varununayak/follow_me_quad/Documentation/ACODS_presentation.pptx

## Target Tracking by a Quadrotor using Proximity Sensor Fusion

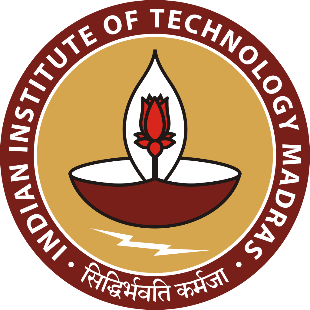
[picture p2: figure]

Varun Nayak[1], Raksha Rao Karaya[2]

[1]: Department of Mechanical Engineering, Birla Institute of Technology and Science, Pilani – K K Birla Goa Campus
[2]: Department of Aerospace Engineering, Indian Institute of Technology Madras

## Background

- Summer research work at the Department of Aerospace Engineering at IIT Madras in the Flight Dynamics and Control Group
- Lab focused on Multirotor Dynamics and Control.
- To develop a low-cost and computationally efficient system on a quadrotor to be able to detect and “follow” a moving object.
- Contribute to the lab’s objective of improving autonomy and efficiency of multirotor systems.

## Literature Review

- Camera and Machine Vision
  - Computational Cost – Ground Station Processing
  - Fails in visually-degraded environments
- Time of Flight Sensors
  - LiDaR – Payload Limitations; Open-ended environments
- Similar work using a combination of light-weight T-o-F sensors
Gageik et al (2015): Combines US and IR sensor but does not demonstrate object tracking

## Objective

- To detect and follow a solid object in front of a quadrotor by regulating its distance from it.
  - Develop this system on top of a low-level attitude controller of the quadrotor.
  - Make best use of available proximity sensors to generate the desired control signal – Filtering and Sensor Fusion
  - Implementation and experimental verification.
- Advantages: Computationally cheap, low-cost, readily available components, independent of light conditions, small payload

## Sensors

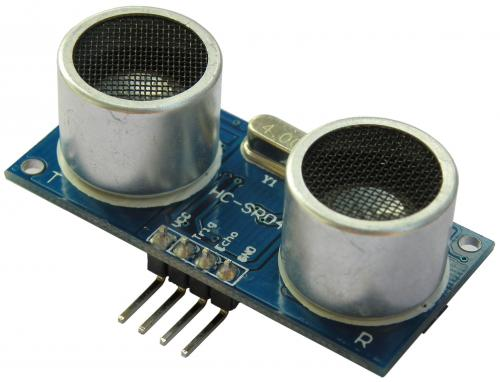
[picture p3: figure]
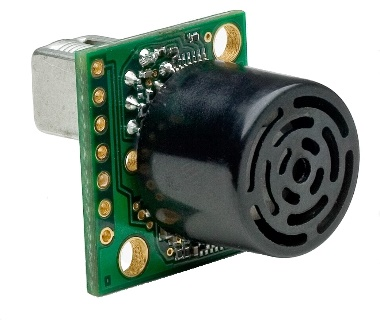
[picture p4: figure]

- Proximity sensors that operate using ultrasonic signals.
- Selection criteria – range, response for nature of surface, noise characteristics, measuring angle.
- Validated from visualizing raw-data.

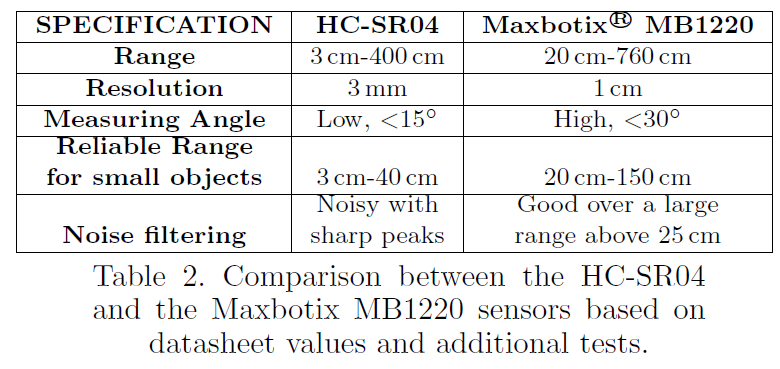
[picture p5: figure]

## Fully-assembled system

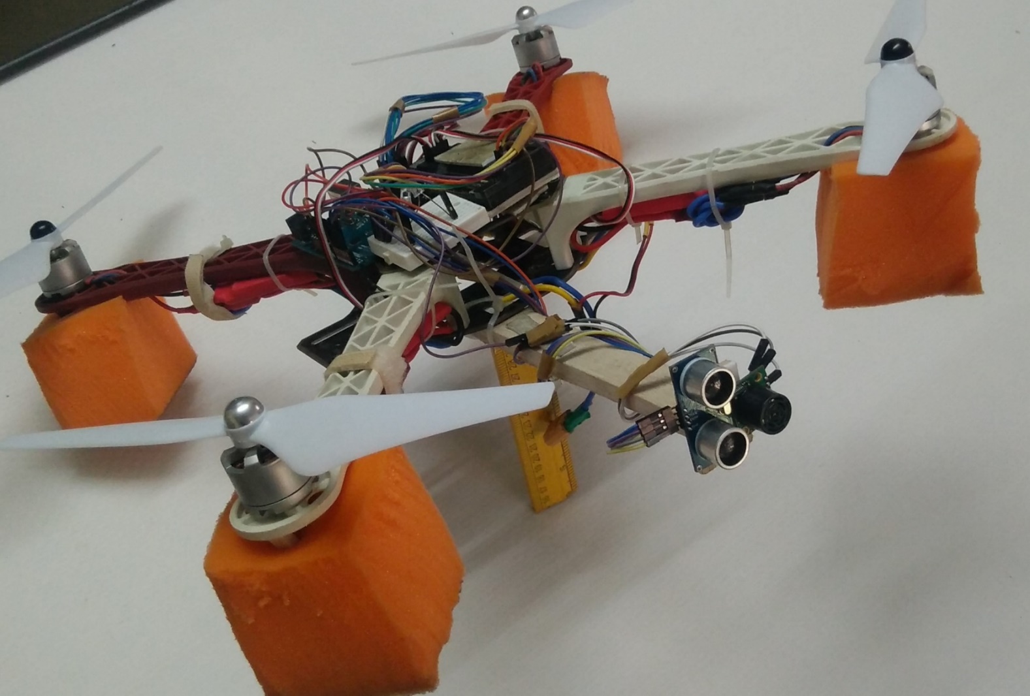
[picture p6: figure]

Flight Controller
+
Companion Board

Proximity Sensors

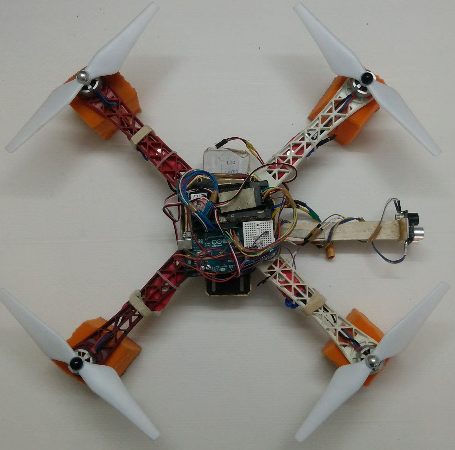
[picture p7: figure]

## Estimation: Filtering

- Important to ensure a smooth and reliable stream of proximity data as the output of the filter will drive the high-level controller of the quadrotors.
- Exponential Smoothening.
- Digital Filter.
- Noise Based (Gaussian) Filter.

## Estimation: Noise-based (Gaussian) filter

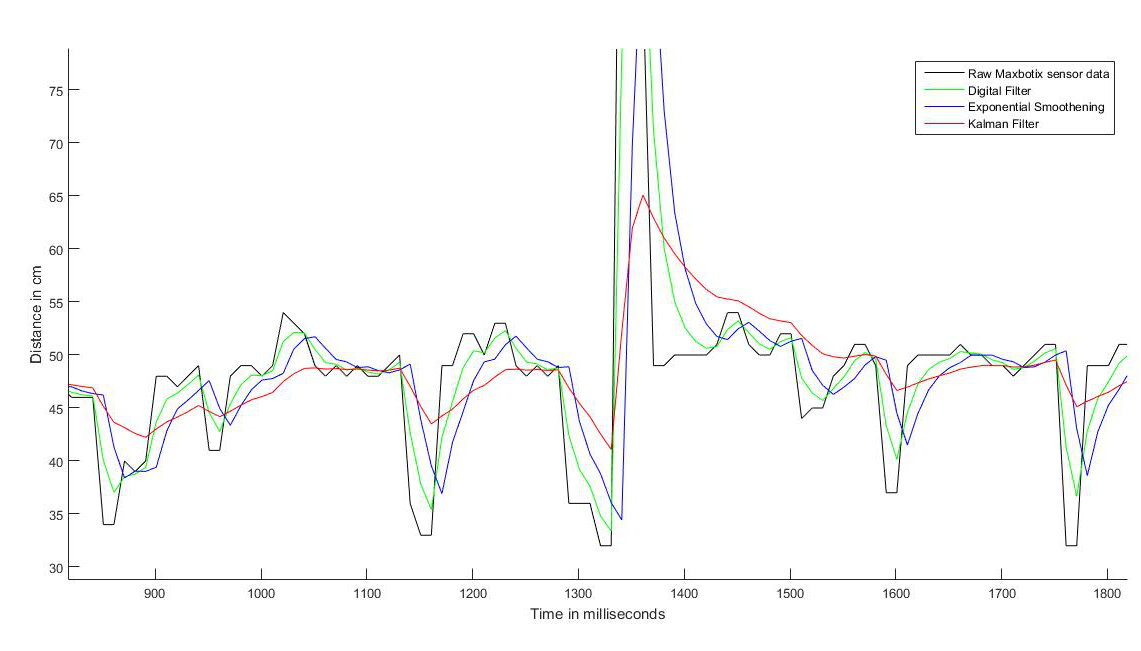
[picture p8: figure]
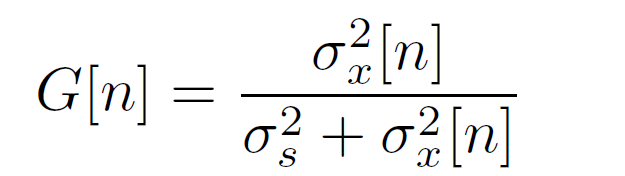
[picture p9: figure]

## Estimation: Sensor Fusion using Sigmoid Function

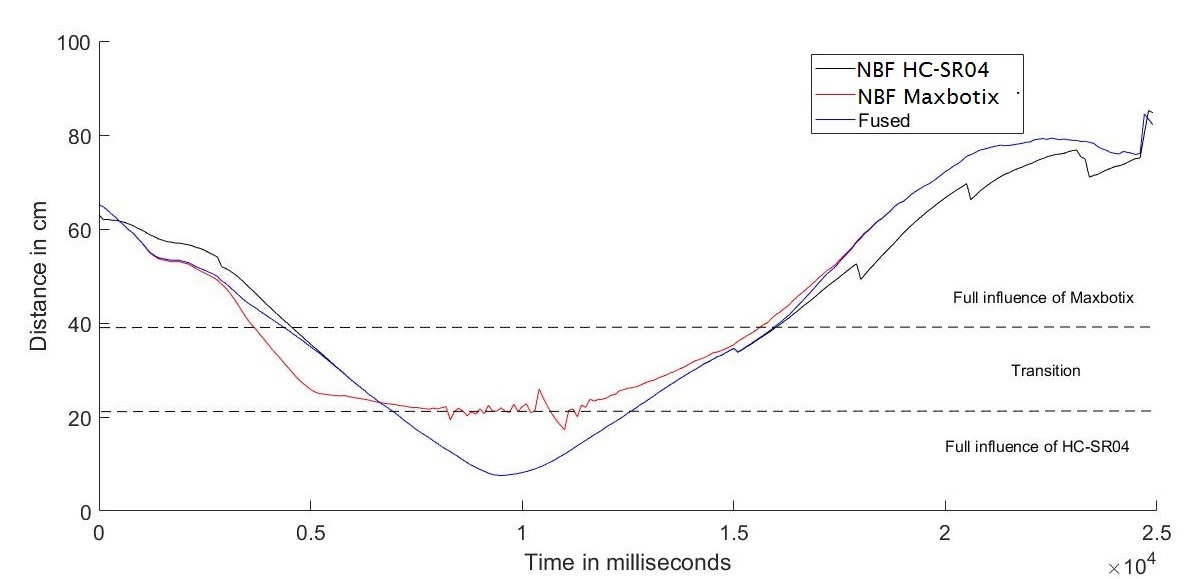
[picture p10: figure]
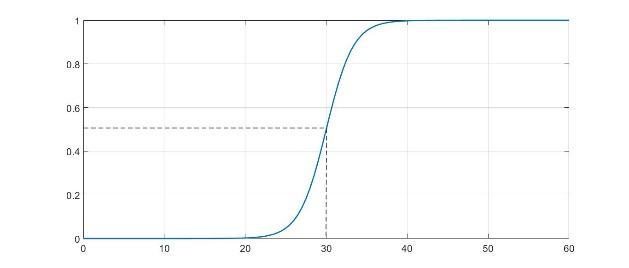
[picture p11: figure]
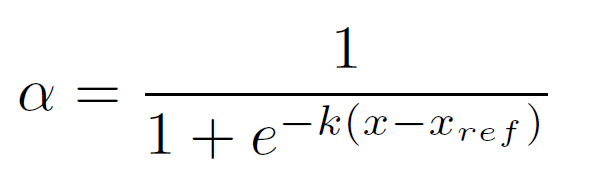
[picture p12: figure]

## System Dynamics

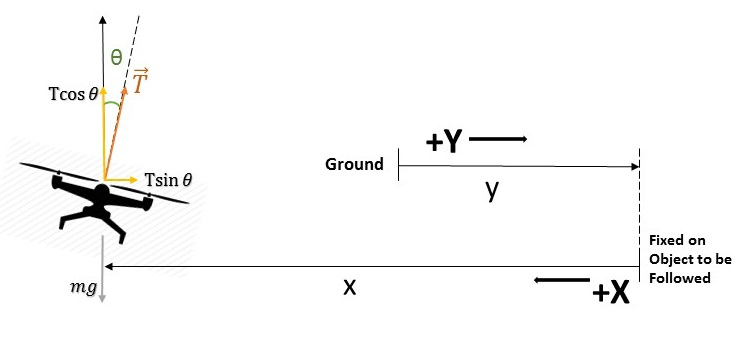
[picture p13: figure]

- Ground frame and frame fixed on moving object
- Balancing the force in the vertical and horizontal directions
- Vertical direction: Static

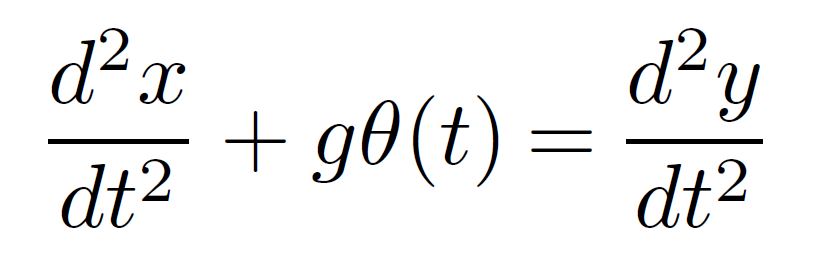
[picture p14: figure]
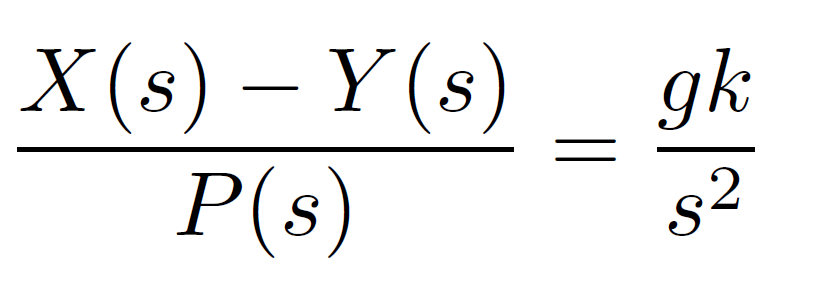
[picture p15: figure]

## Simulink Model of Closed-Loop Dynamics

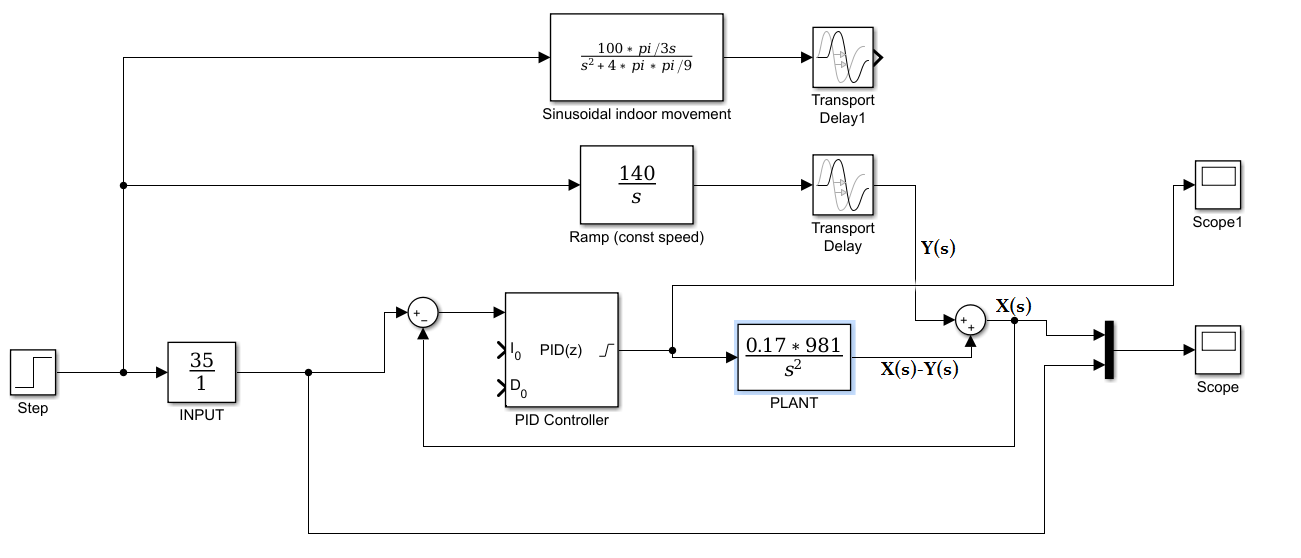
[picture p16: figure]

Objective: To estimate the PID gains required to perform successful trajectory tracking

## Simulation Results

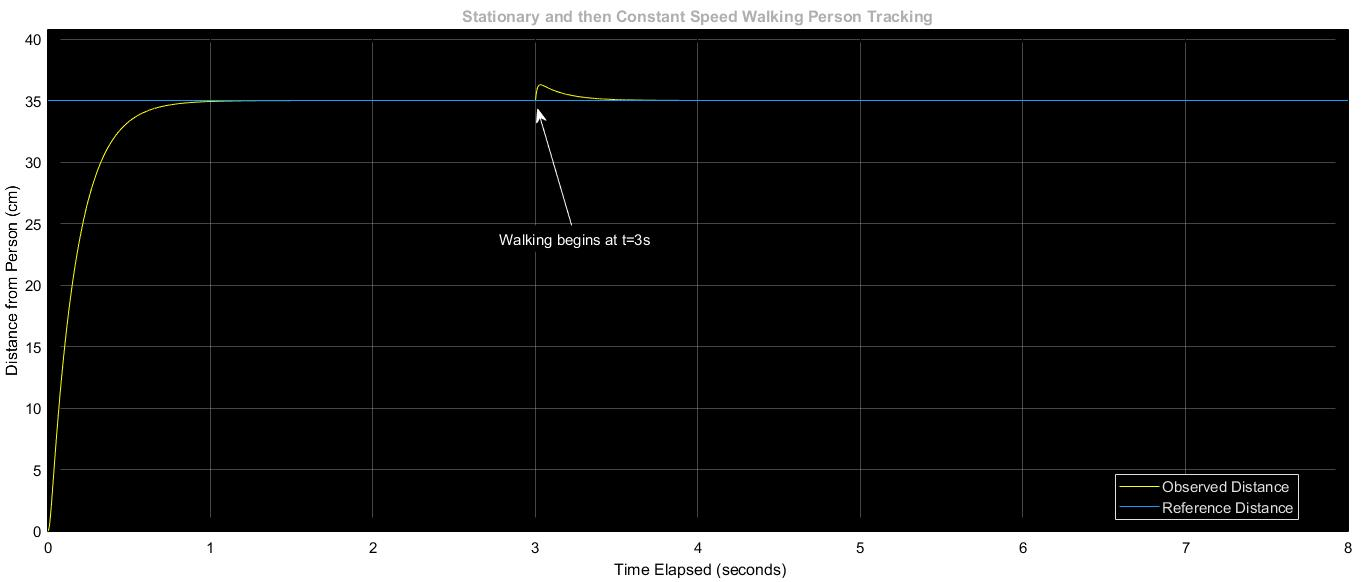
[picture p17: figure]

Linear Movement

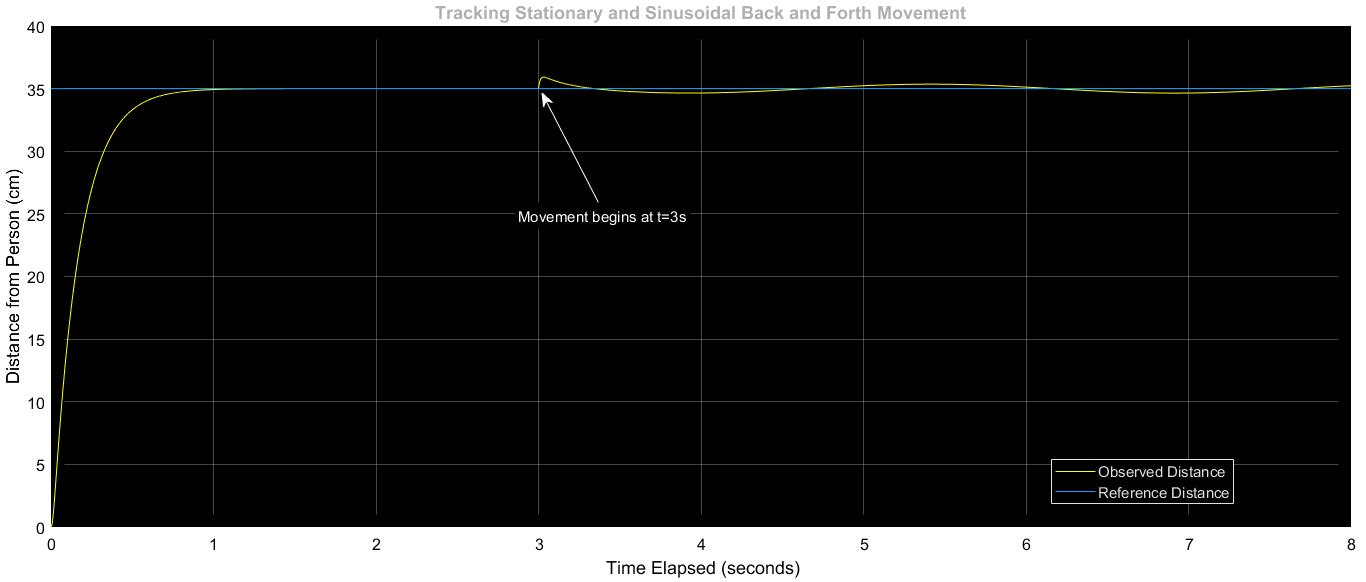
[picture p18: figure]

Simulation of the PID Controller on MATLAB: Shows errors of less than 3 cm.

Sinusoidal Movement

## Hardware Implementation

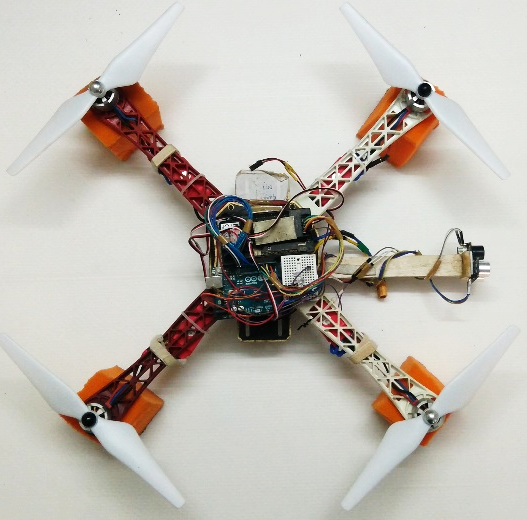
[picture p19: figure]
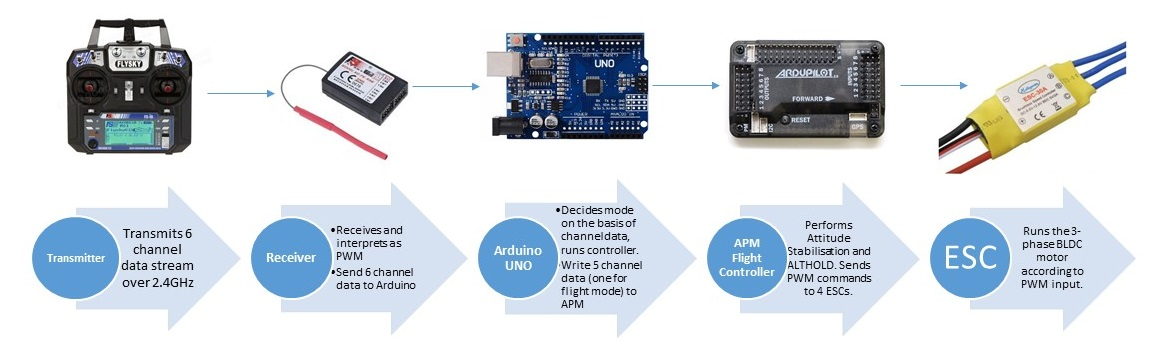
[picture p20: figure]

## Algorithm Flow Chart (implemented on the companion board-Arduino)

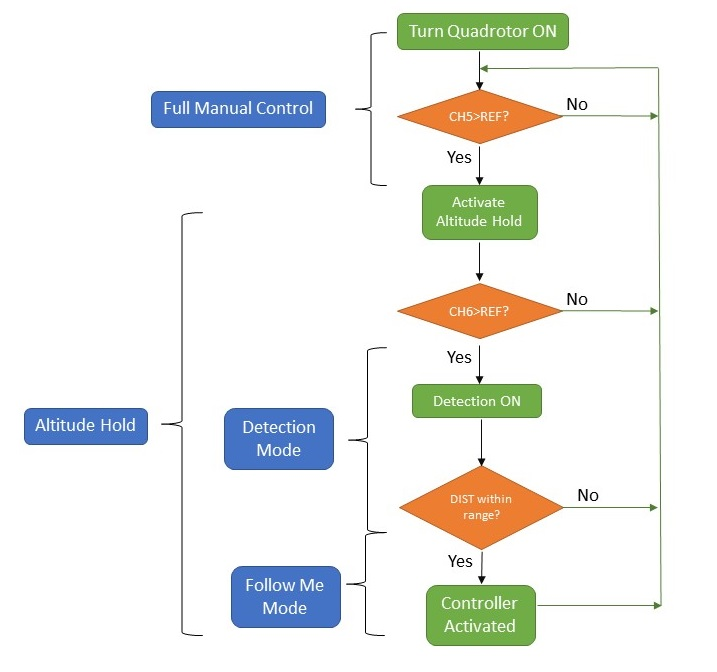
[picture p21: figure]

- Three Modes:
  1. Manual
  2. Alt Hold
  3. “Follow Me”
- Control law for Pitch Reference input signal that would translate the quadrotor.

## Results

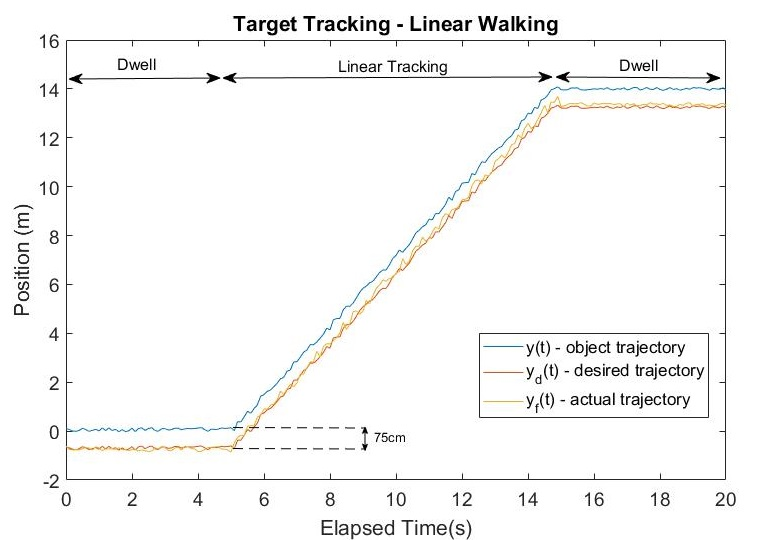
[picture p22: figure]
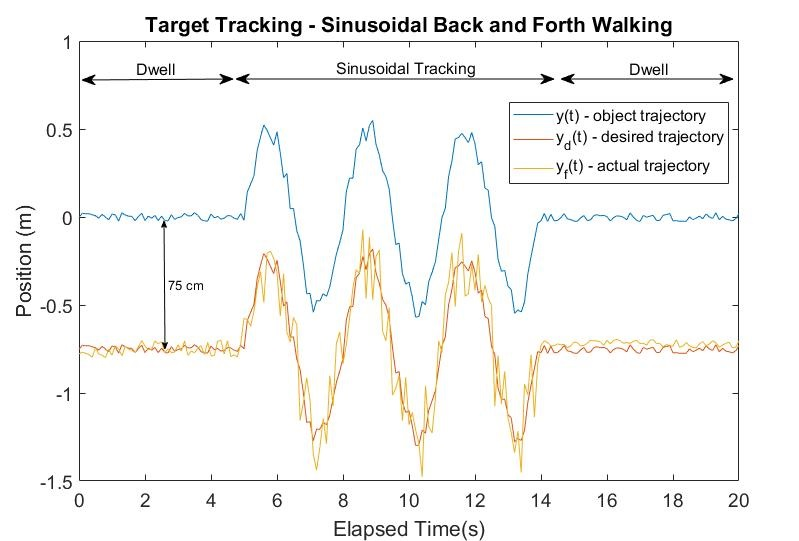
[picture p23: figure]

Errors of the order of 20cm. However, tracking is performed successfully for the intended application.

## Conclusion

- Cheap (developed under $150) and effective method to detect and track moving references in space using ultrasonic sensors. Such systems can be used for localization and tracking applications.
- Limitation 1: The sensor readings were affected by the pitch angle because of the fixed mounting
- Limitation 2 : Interference between the sensors added to noise

## Thank you

Questions?
